Inderen99/drone/Schematic/Drone_noter.txt

Notes:

PWM:
- When we want to change the frequency for the pwm signals, look at the following page: https://www.pjrc.com/teensy/td_pulse.html
- Pay attention 

MCU:
- Current consumption ok - but is it a problem that it receives a "constant" current supply of 500mA
- Add LED 
- Add measure wires

Communication:
- SBUS on UART pin
- Pay attention to the invertion of SBUS signal compared to the UART 

Debug pins:
- Remember these!

Blinking Led:
- To see that MCU is alive:))

Software:
- Interrupts

Circuit overview:
- https://www.godrone.dk/esc-electronic-speed-control/

SPI design:
- https://www.pjrc.com/better-spi-bus-design-in-3-steps/

GPS:
- Keep antenna away from circuitry
- Omslut RF banen med ground (allerede gjort??)

RC modtager:
- Stik til RC modtager
- Uart på MCU

Connectors til battery:
- LAV DISSE

Connectors til antennen:
- SMA 

Connector til ESC:
- XT60

Bestilling komponenter:
- Teensy
- Batterier
- Motorer
- MPU9250 modul
- 

Schematic:
- Det vi manglede sidst - ok nu?
- Er kredsløbet ordentligt beskyttet

Antenne:
- Kig på impedansen mellem ledning og ground plane
- Hold ledningen så kort som muligt

Connectors:
- 

Propeller:
- 

Teensy Propshield - skal bruges til magnetometer kalibrering

Kontakt Jacob Pedersen!
