Inderen99/drone/(commit log)

2022-03-20 Schematic update
    [Drone.kicad_pcb, Drone.kicad_sch, Drone.sch]
2022-03-21 Schematic done
